Juliaj/lidarbot/3D-stls/bottom-plate-5.stl

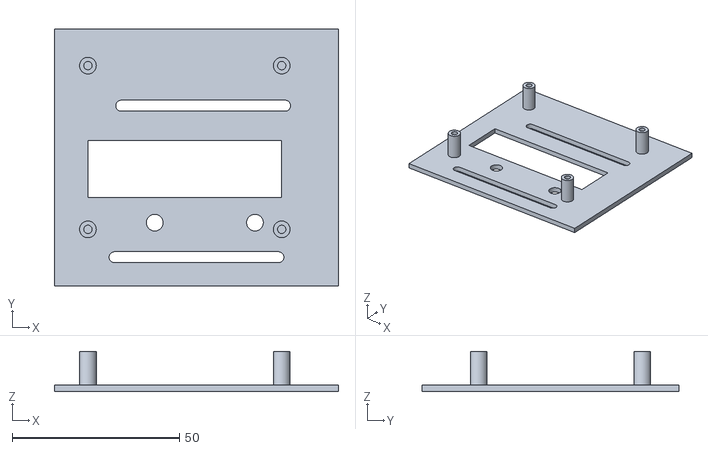
[picture p1: CAD file, 2025-09-08]
3D-stls/bottom-plate-5.stl
85.0 x 77.0 x 12.0
