Juliaj/lidarbot/3D-stls/lidar-camera-mount-2.stl

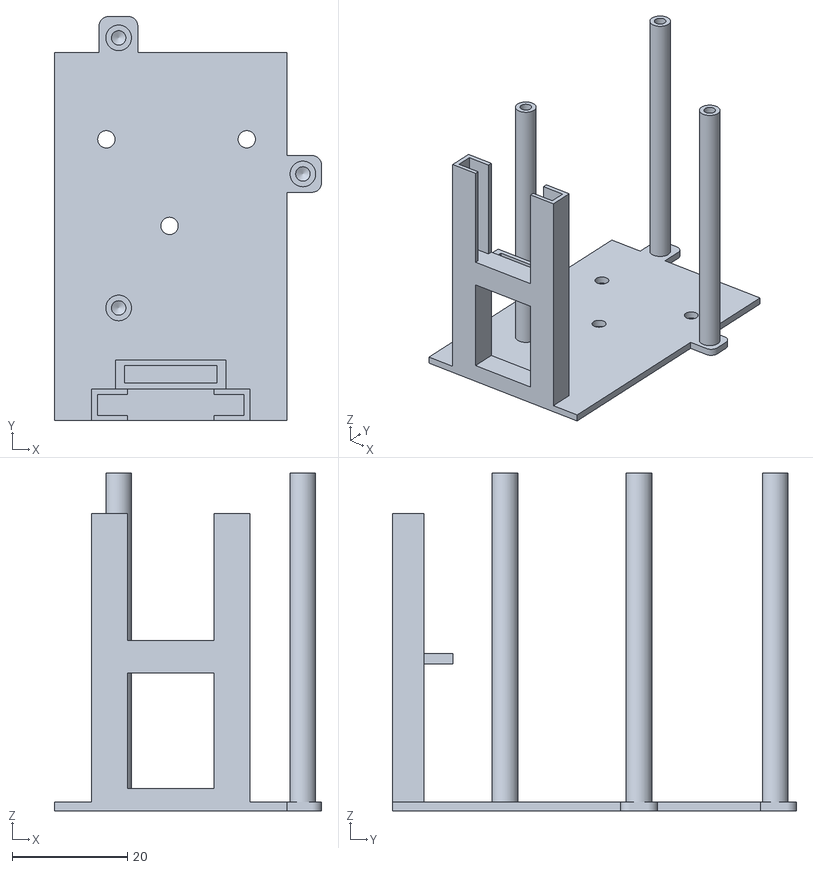
[picture p2: CAD file, 2025-09-08]
3D-stls/lidar-camera-mount-2.stl
46.3 x 70.0 x 58.5
