Juliaj/lidarbot/3D-stls/imu-mount-2.stl

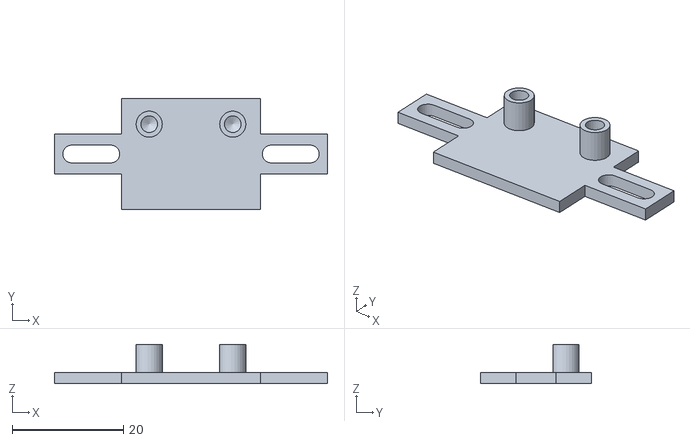
[picture p3: CAD file, 2025-09-08]
3D-stls/imu-mount-2.stl
49.0 x 20.0 x 7.00
