Juliaj/lidarbot/lidarbot_base/include/lidarbot_base/motor_encoder.h

#ifdef __cplusplus
extern "C" {
#endif

#ifndef __MOTOR_ENCODER_H__
#define __MOTOR_ENCODER_H__

#include <stdio.h>
#include <stdlib.h>
#include <signal.h>
#include <wiringPi.h>

#include "MotorDriver.h"

// back up, in rviz2, forward command shows the robot was rotating
#define LEFT_WHL_ENC_INT 23
#define LEFT_WHL_ENC_DIR 22

#define RIGHT_WHL_ENC_INT 24
#define RIGHT_WHL_ENC_DIR 25


void handler(int signo);
void left_wheel_pulse();
void right_wheel_pulse();
void set_motor_speeds(double left_wheel_command, double right_wheel_command);
void read_encoder_values(int *left_encoder_value, int *right_encoder_value);

extern int left_wheel_pulse_count;
extern int right_wheel_pulse_count;
extern int left_wheel_direction;
extern int right_wheel_direction;

#endif

#ifdef __cplusplus
}
#endif
