Juliaj/lidarbot/lidarbot_bringup/include/lidarbot_bringup/mpu6050_lib.h

//-------------------------------MPU6050 Accelerometer and Gyroscope C++ library-----------------------------
//Made changes to class and renamed file. Adapted from Alex Mous (https://github.com/alex-mous/MPU6050-C-CPP-Library-for-Raspberry-Pi)
//Copyright (c) 2019, Alex Mous
//Licensed under the CC BY-NC SA 4.0


//-----------------------MODIFY THESE PARAMETERS-----------------------

#define GYRO_RANGE 0 //Select which gyroscope range to use (see the table below) - Default is 0
//	Gyroscope Range
//	0	+/- 250 degrees/second
//	1	+/- 500 degrees/second
//	2	+/- 1000 degrees/second
//	3	+/- 2000 degrees/second
//See the MPU6000 Register Map for more information


#define ACCEL_RANGE 0 //Select which accelerometer range to use (see the table below) - Default is 0
//	Accelerometer Range
//	0	+/- 2g
//	1	+/- 4g
//	2	+/- 8g
//	3	+/- 16g
//See the MPU6000 Register Map for more information


//Offsets - supply your own here (calculate offsets with getOffsets function)
//    Gyroscope
#define G_OFF_X -507
#define G_OFF_Y -139
#define G_OFF_Z -81
//     Accelerometer
#define A_OFF_X 32768
#define A_OFF_Y -939
#define A_OFF_Z -11907

//-----------------------END MODIFY THESE PARAMETERS-----------------------

#include <iostream>
#include <unistd.h>
#include <fcntl.h>
#include <sys/ioctl.h>
#include <sys/types.h>
#include <time.h>
extern "C" {
	#include <linux/i2c-dev.h>
	#include <i2c/smbus.h>
}
#include <cmath>
#include <thread>

#define _POSIX_C_SOURCE 200809L //Used for calculating time

#define TAU 0.05 //Complementary filter percentage
#define RAD_T_DEG 57.29577951308 //Radians to degrees (180/PI)
#define M_PER_SECS_SQUARED 9.80665 //Acceleration G-unit to m/s^2

//Select the appropriate settings
#if GYRO_RANGE == 1
	#define GYRO_SENS 65.5
	#define GYRO_CONFIG 0b00001000
#elif GYRO_RANGE == 2
	#define GYRO_SENS 32.8
	#define GYRO_CONFIG 0b00010000
#elif GYRO_RANGE == 3
	#define GYRO_SENS 16.4
	#define GYRO_CONFIG 0b00011000
#else //Otherwise, default to 0
	#define GYRO_SENS 131.0
	#define GYRO_CONFIG 0b00000000
#endif
#undef GYRO_RANGE


#if ACCEL_RANGE == 1
	#define ACCEL_SENS 8192.0
	#define ACCEL_CONFIG 0b00001000
#elif ACCEL_RANGE == 2
	#define ACCEL_SENS 4096.0
	#define ACCEL_CONFIG 0b00010000
#elif ACCEL_RANGE == 3
	#define ACCEL_SENS 2048.0
	#define ACCEL_CONFIG 0b00011000
#else //Otherwise, default to 0
	#define ACCEL_SENS 16384.0
	#define ACCEL_CONFIG 0b00000000
#endif
#undef ACCEL_RANGE

struct Quaternion
{
	double w, x, y, z;
};

class MPU6050 {
	private:
		void _update();

		float _accel_angle[3];
		float _gyro_angle[3];
		float _angle[3]; //Store all angles (accel roll, accel pitch, accel yaw, gyro roll, gyro pitch, gyro yaw, comb roll, comb pitch comb yaw)

		float ax, ay, az, gr, gp, gy; //Temporary storage variables used in _update()

		int MPU6050_addr;
		int f_dev; //Device file

		float dt; //Loop time (recalculated with each loop)

		struct timespec start,end; //Create a time structure

		bool _first_run = 1; //Variable for whether to set gyro angle to acceleration angle in compFilter
	public:
		MPU6050(int8_t addr);
		MPU6050(int8_t addr, bool run_update_thread);
		void getAccelRaw(float *x, float *y, float *z);
		void getGyroRaw(float *roll, float *pitch, float *yaw);
		void getAccel(float *x, float *y, float *z);
		void getGyro(float *roll, float *pitch, float *yaw);
		void getOffsets(float *ax_off, float *ay_off, float *az_off, float *gr_off, float *gp_off, float *gy_off);
		Quaternion getQuat(float *roll, float *pitch, float *yaw);
		int getAngle(int axis, float *result);
		bool calc_yaw;
};
