Juliaj/lidarbot/lidarbot_base/include/lidarbot_base/Debug.h

/*****************************************************************************
* | File      	:	Debug.h
* | Author      :   Waveshare team
* | Function    :	debug with printf
* | Info        :
*----------------
* |	This version:   V1.0
* | Date        :   2018-01-11
* | Info        :   Basic version
*
******************************************************************************/
#ifndef __DEBUG_H
#define __DEBUG_H

#include <stdio.h>

#define USE_DEBUG 0
#if USE_DEBUG
	#define DEBUG(__info,...) printf("Debug : " __info,##__VA_ARGS__)
#else
	#define DEBUG(__info,...)
#endif

#endif
