Juliaj/lidarbot/(commit log)

2025-08-29 Add custom build of the bot
    [camera.xacro, chessboard_calibration.yaml, controllers.yaml, gazebo_control.xacro, imu.xacro, inertial_macros.xacro, lidar.xacro, lidarbot.urdf.xacro]
2025-09-08 Fix the encoder pin for right wheel
    [bottom-plate-5.stl, imu-mount-2.stl, lidar-camera-mount-2.stl, lidar.xacro]
2025-09-08 Add local updates from rpi
    [controllers.yaml]
2025-09-09 Fix merging conflicts
    [controllers.yaml]
2025-09-09 Update the gazebo files for Jazzy
    [lidarbot_gz.urdf.xacro, lidarbot_gz_core.xacro, sensors.xacro]
2025-09-09 Update gazebo related xacro files
    [imu.xacro, lidar.xacro, sensors.xacro]
2025-09-16 Fixed the right wheel direction issue
    [controllers.yaml]
